NeoProg2013/EDM/blueprint/Пульт/20260916_1610_image (1).png

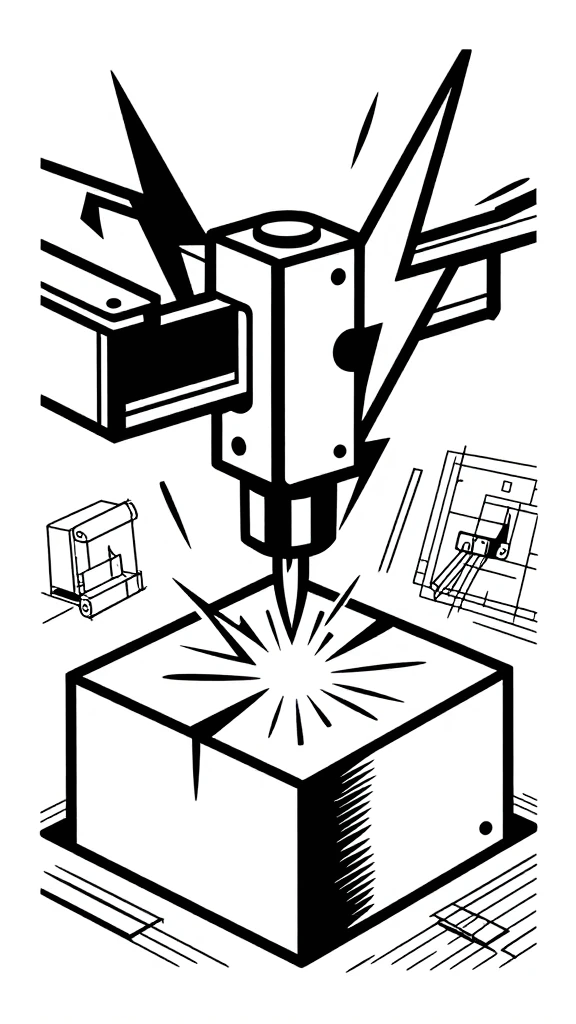
blueprint/Пульт/20260916_1610_image (1).png
