NeoProg2013/EDM/blueprint/Пульт/HighVoltage.webp

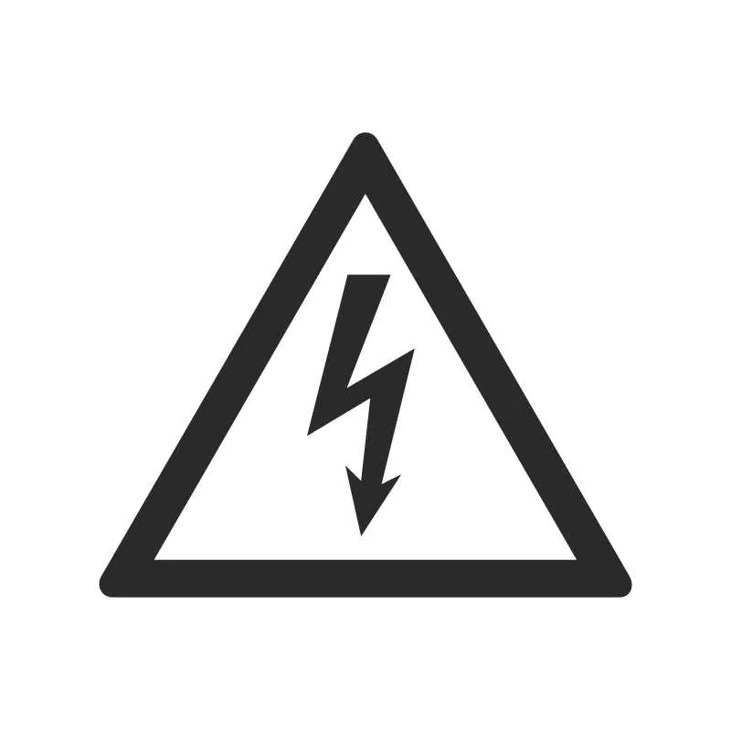
blueprint/Пульт/HighVoltage.webp
