NeoProg2013/EDM/blueprint/Пульт/on-off.png

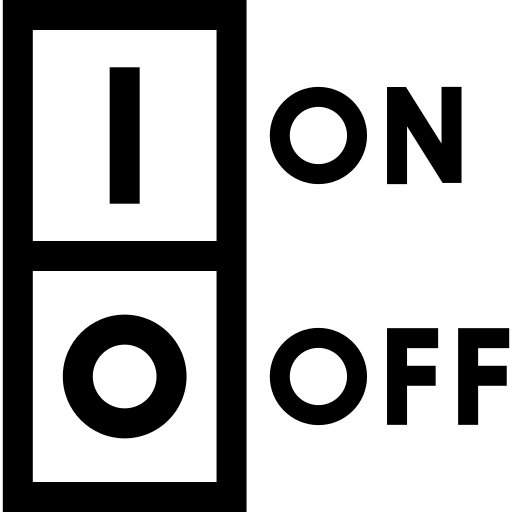
blueprint/Пульт/on-off.png
