NeoProg2013/EDM/blueprint/Снимок экрана 2026-05-17 213727.png

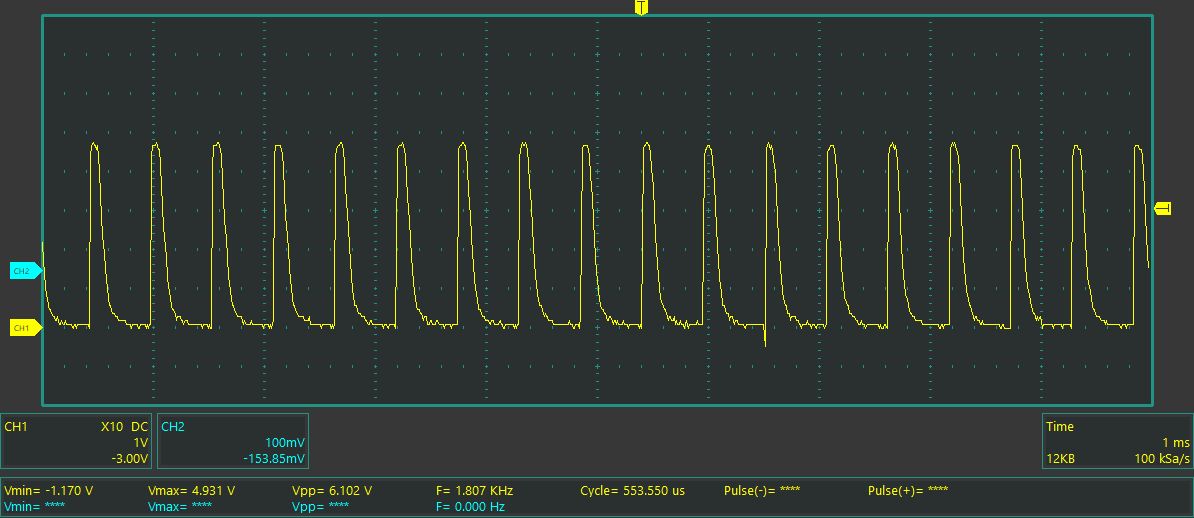
blueprint/Снимок экрана 2026-05-17 213727.png
