NeoProg2013/EDM/firmware/STM32F407VET6.png

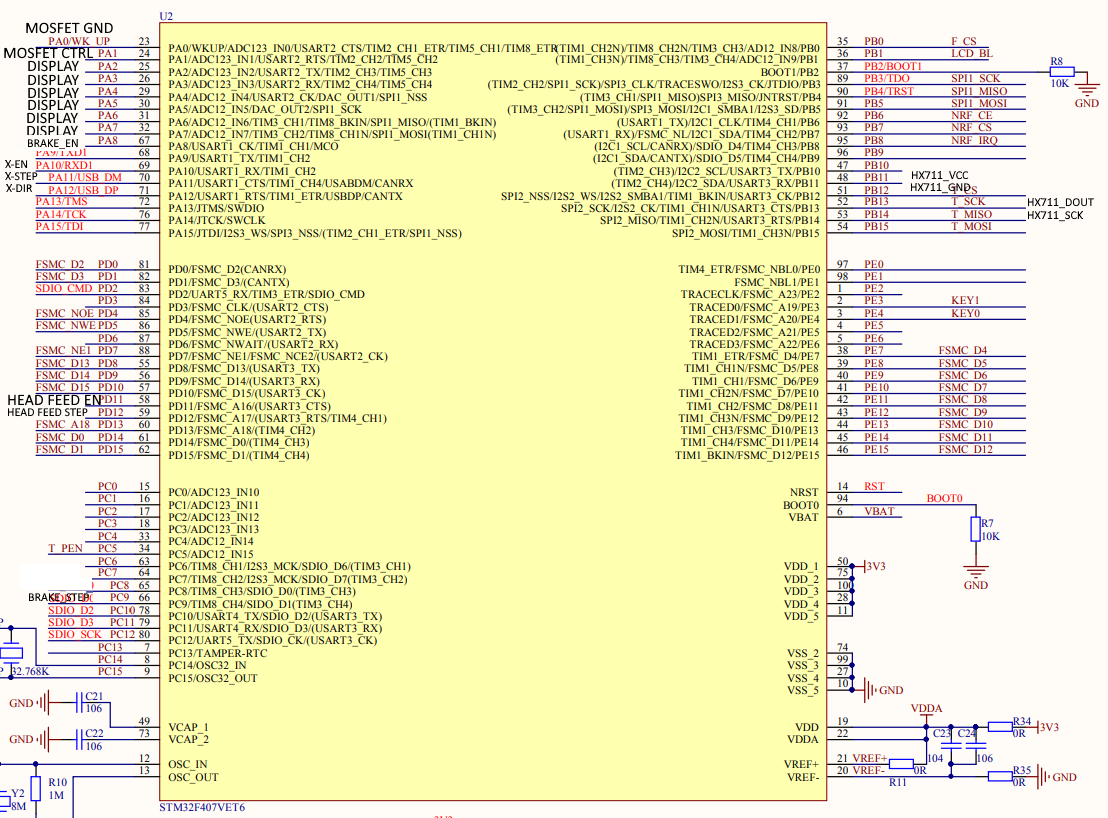
firmware/STM32F407VET6.png
