NeoProg2013/EDM/hardware/laser/bottom.bmp

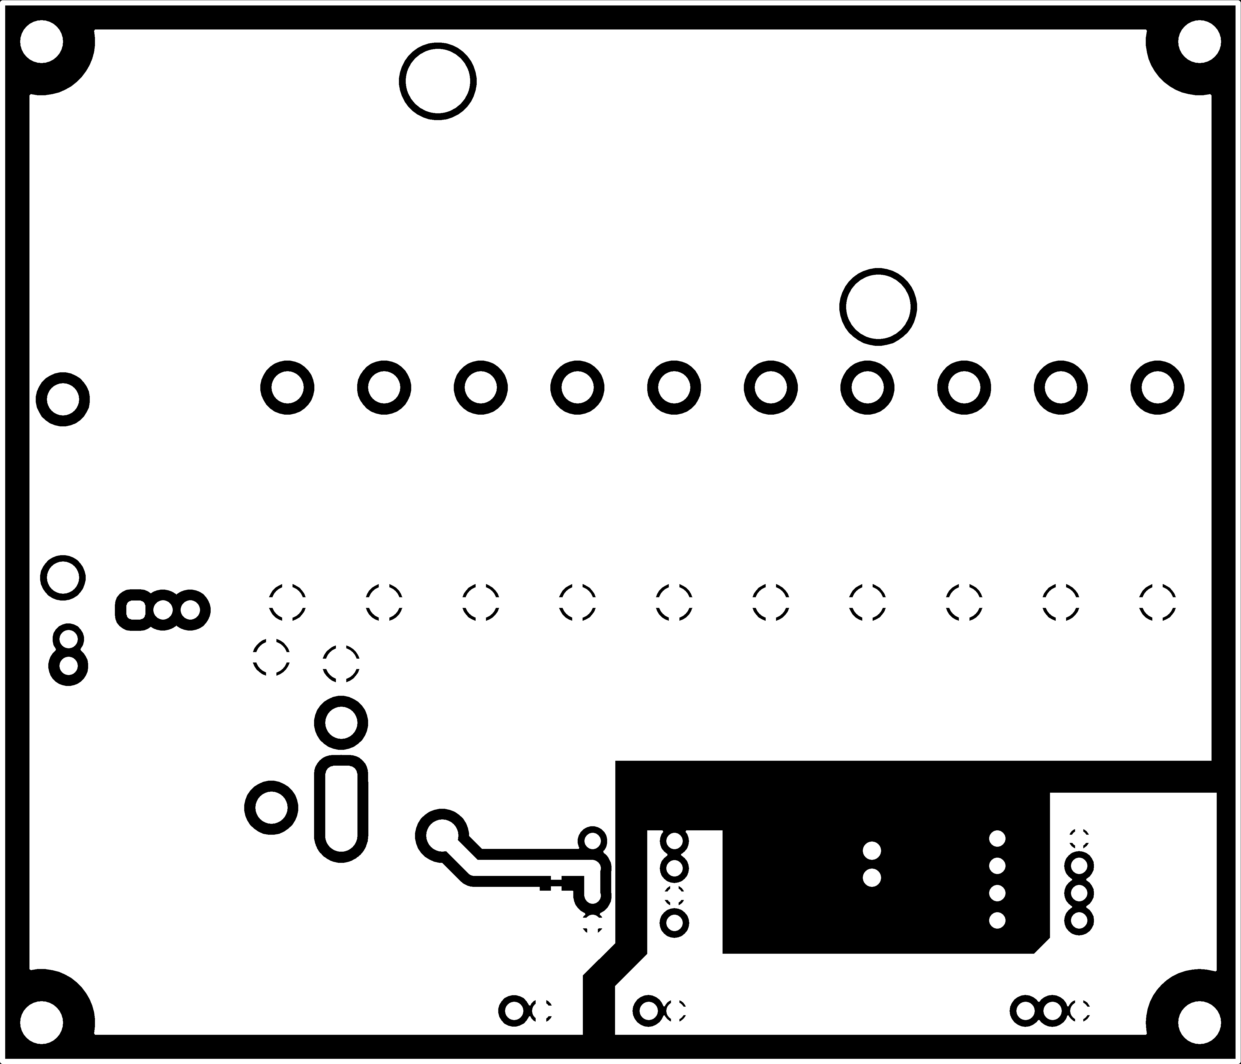
hardware/laser/bottom.bmp
