NeoProg2013/EDM/hardware/laser/top.bmp

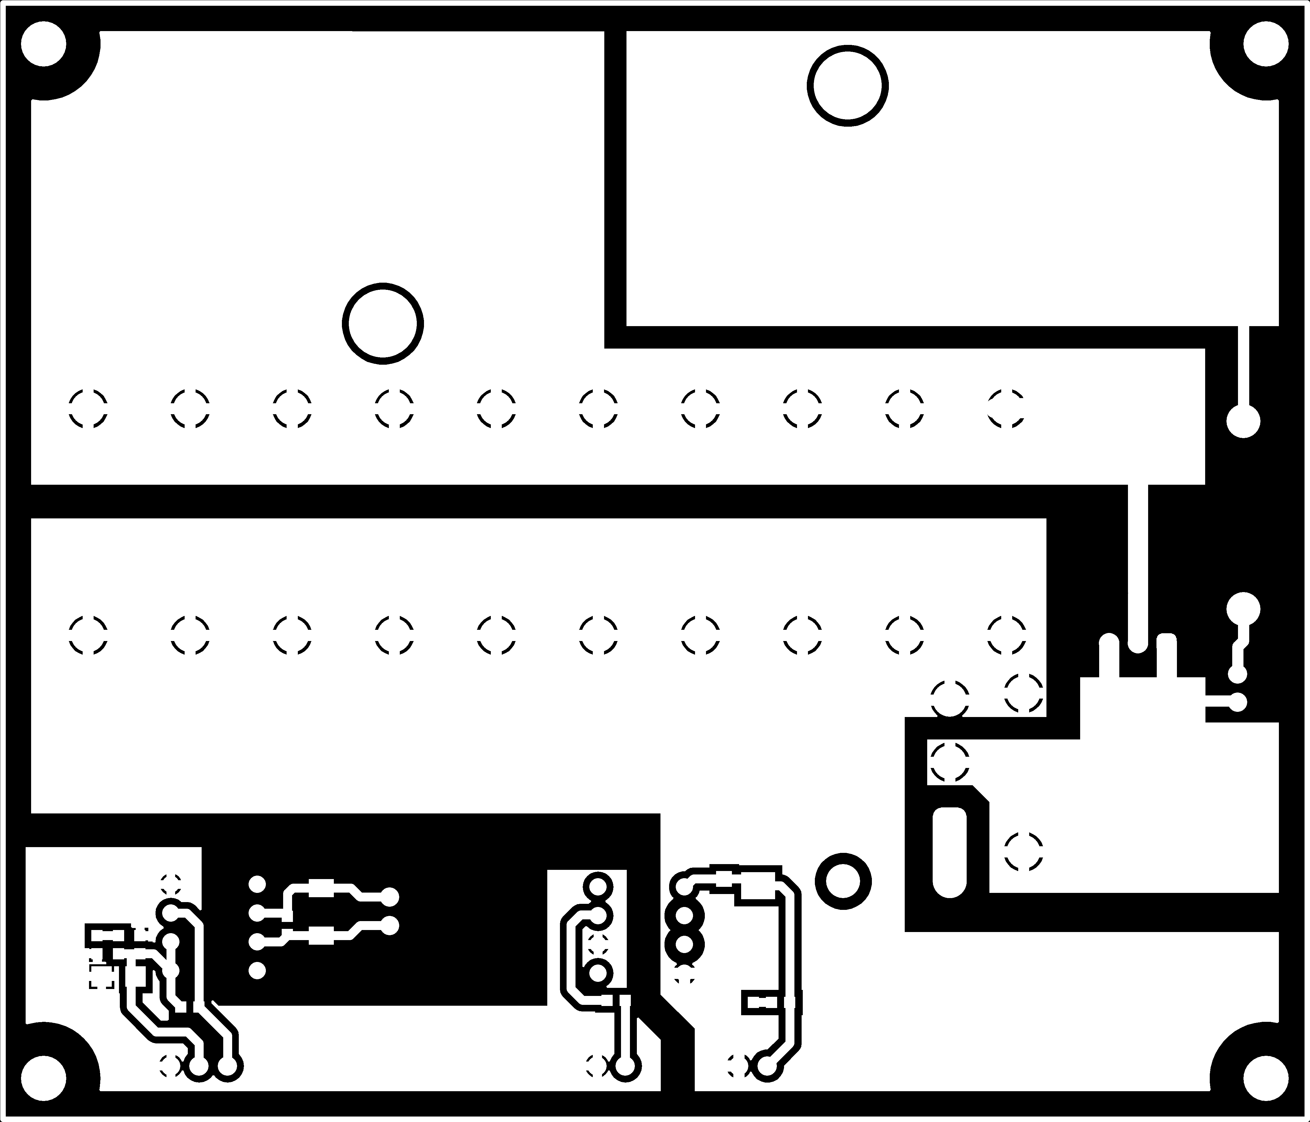
hardware/laser/top.bmp
