NeoProg2013/EDM/img/1.png

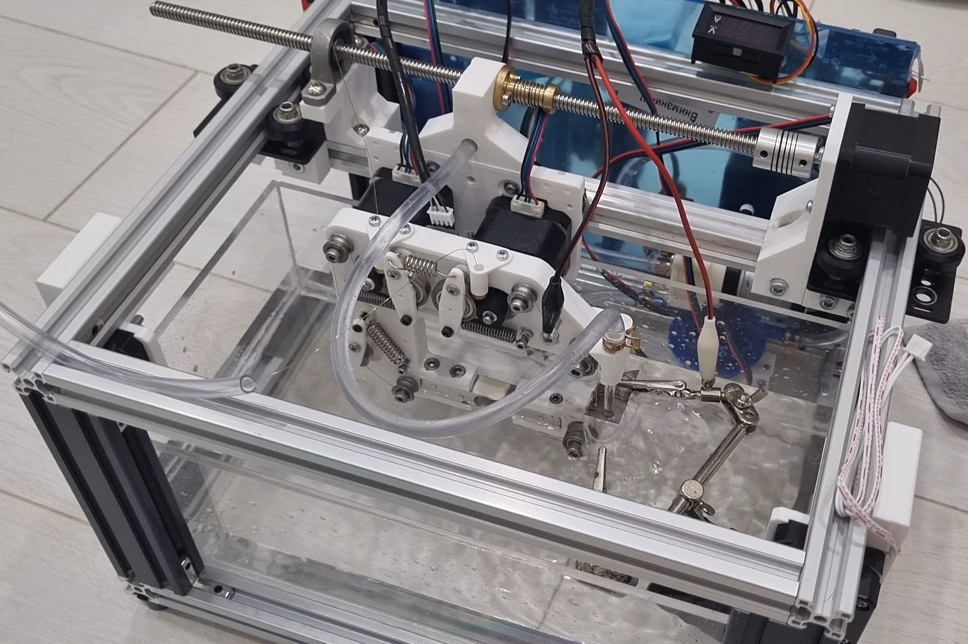
img/1.png
