NeoProg2013/EDM/blueprint/3rd/Mofset module/MosfetBoard v6.step

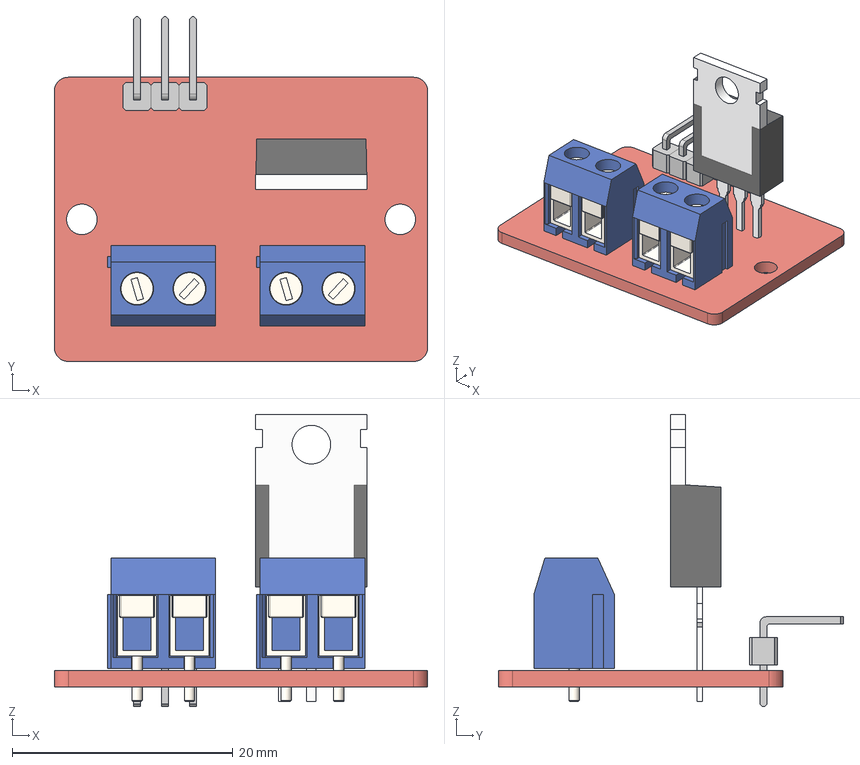
[picture p15: CAD file, 2026-09-25]
blueprint/3rd/Mofset module/MosfetBoard v6.step
33.8 x 31.3 x 26.5 mm
Terminal Screw x 2
FQP30N06L MOSFET With Leads_1
Pin x 3
