NeoProg2013/EDM/blueprint/Аквариум/Кронштейн.stl

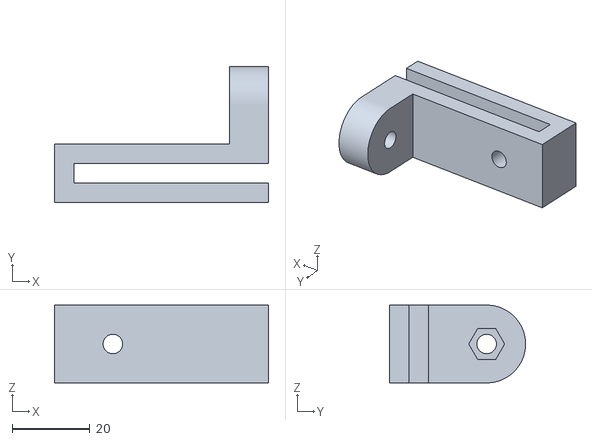
[picture p16: CAD file, 2026-09-25]
blueprint/Аквариум/Кронштейн.stl
55.0 x 35.0 x 20.0
