NeoProg2013/EDM/blueprint/Головка/Кронштейн тефлоновой трубки.stl

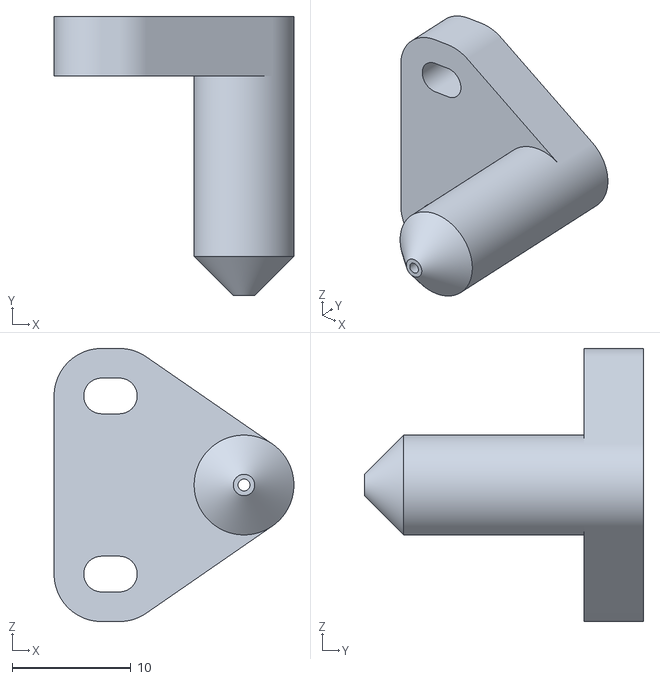
[picture p17: CAD file, 2026-09-25]
blueprint/Головка/Кронштейн тефлоновой трубки.stl
20.2 x 23.5 x 23.0
