NeoProg2013/EDM/blueprint/Пульт/laser.dxf

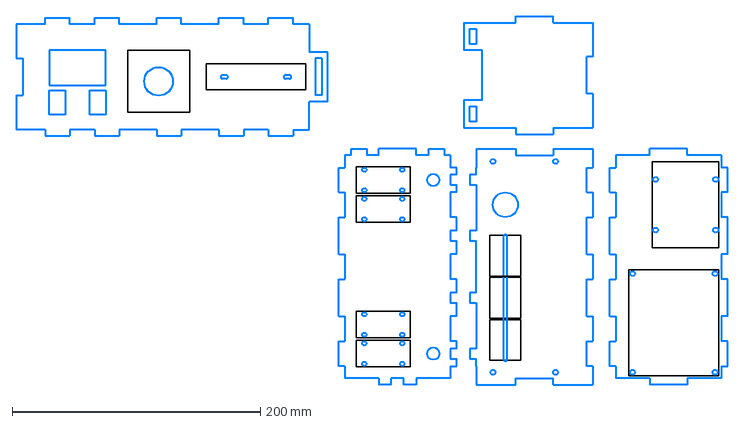
[picture p18: CAD file, 2026-09-25]
blueprint/Пульт/laser.dxf
573.1 x 296.9 mm
