NeoProg2013/EDM/blueprint/Система перекачки жидкости/Кронштайн магнитного фильтра.stl

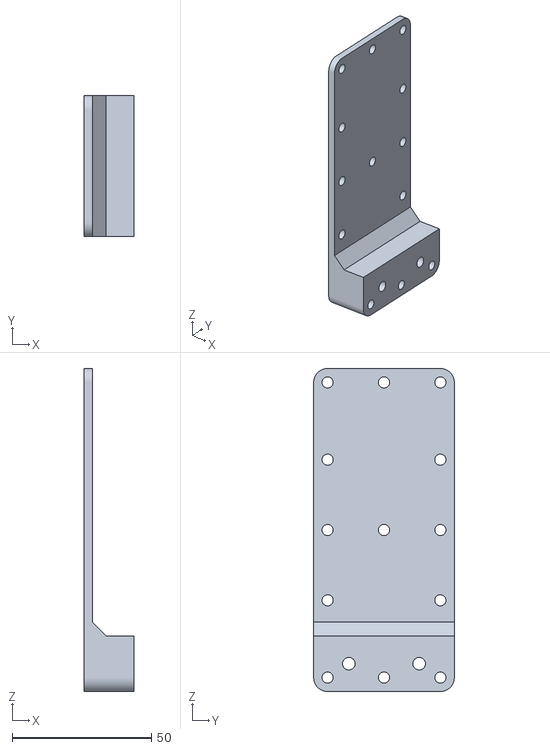
[picture p19: CAD file, 2026-09-25]
blueprint/Система перекачки жидкости/Кронштайн магнитного фильтра.stl
18.0 x 50.5 x 116.0
