NeoProg2013/EDM/blueprint/Система перемотки проволоки/Фиксатор оси.stl

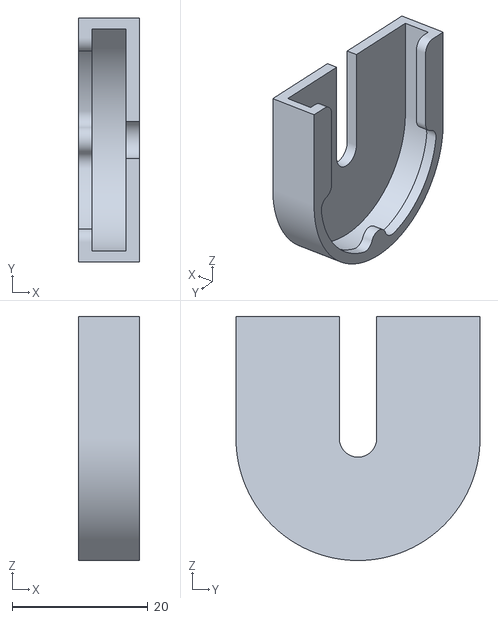
[picture p20: CAD file, 2026-09-25]
blueprint/Система перемотки проволоки/Фиксатор оси.stl
9.00 x 36.0 x 36.0
