NeoProg2013/EDM/blueprint/Аквариум/Кронштейн-2.stl

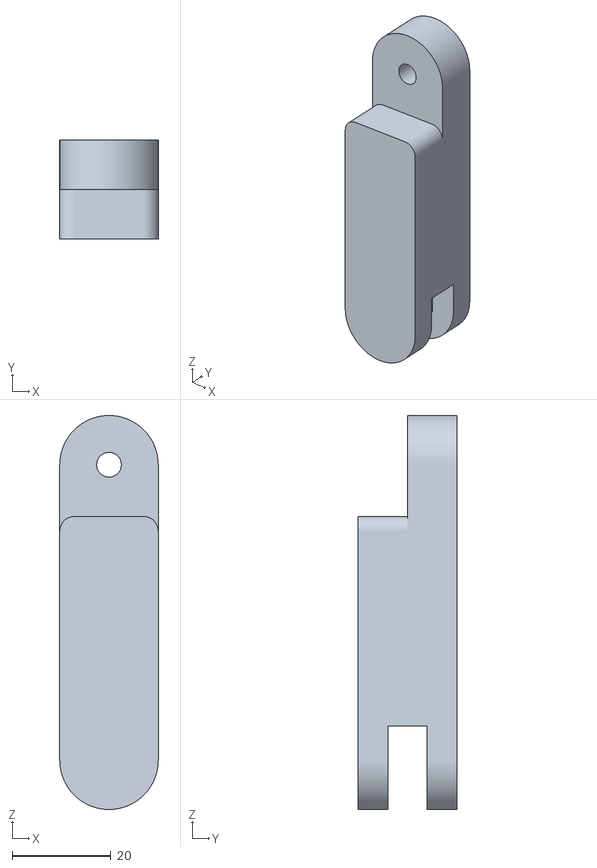
[picture p21: CAD file, 2026-09-25]
blueprint/Аквариум/Кронштейн-2.stl
20.0 x 20.0 x 80.0
