NeoProg2013/EDM/blueprint/Система перекачки жидкости/Магнитный фильтр (крышка).stl

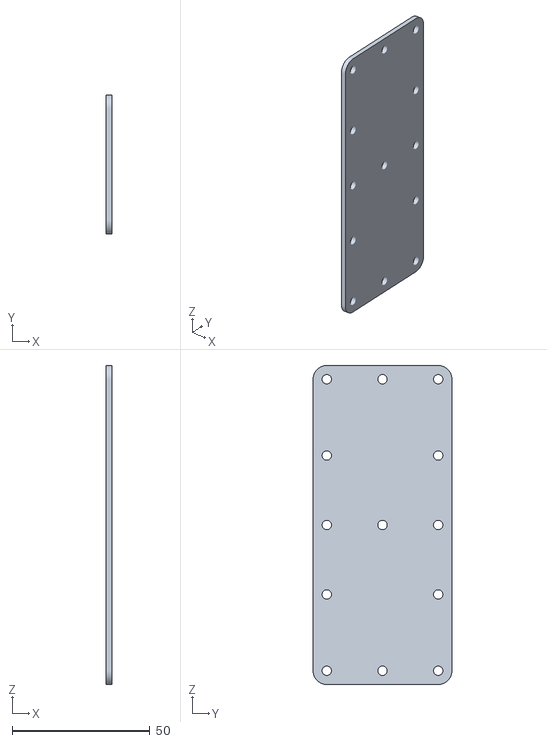
[picture p22: CAD file, 2026-09-25]
blueprint/Система перекачки жидкости/Магнитный фильтр (крышка).stl
2.00 x 50.5 x 116.0
