NeoProg2013/EDM/blueprint/Система перемотки проволоки/Направляющая.stl

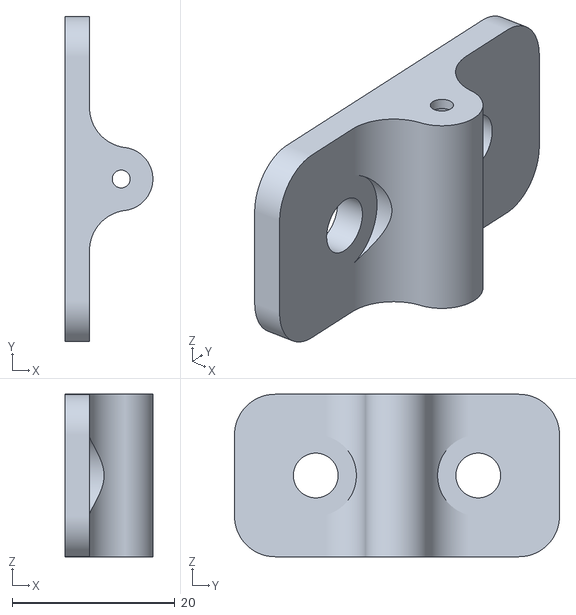
[picture p23: CAD file, 2026-09-25]
blueprint/Система перемотки проволоки/Направляющая.stl
10.8 x 40.0 x 20.0
