NeoProg2013/EDM/blueprint/Система перемотки проволоки/Направляющая тефлоновой трубки.stl

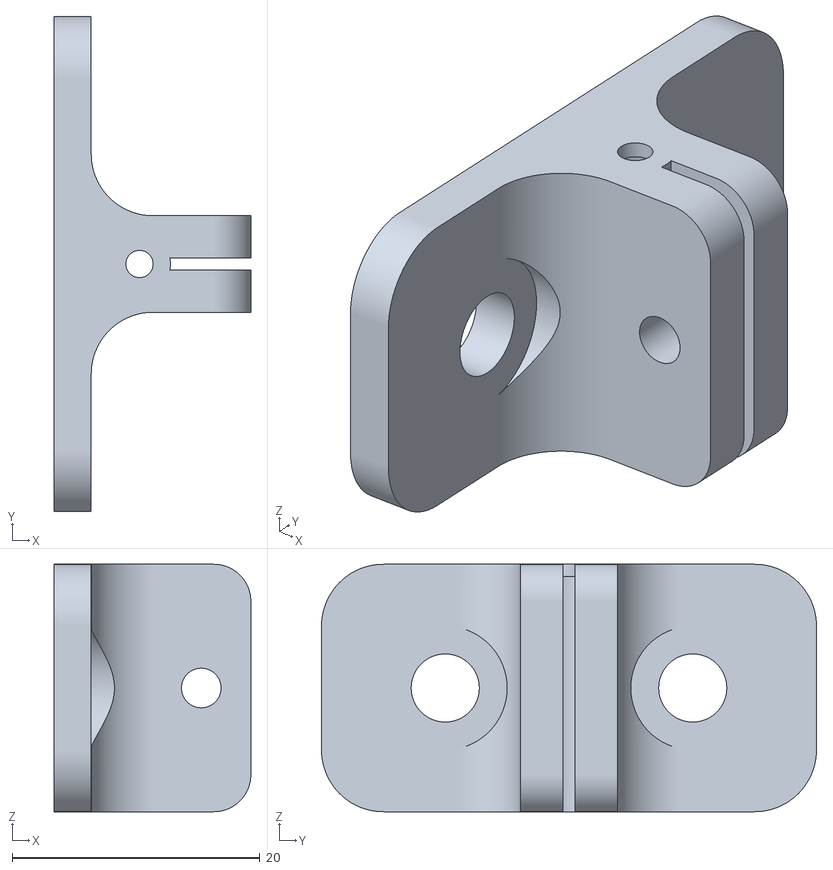
[picture p24: CAD file, 2026-09-25]
blueprint/Система перемотки проволоки/Направляющая тефлоновой трубки.stl
15.9 x 40.0 x 20.0
