NeoProg2013/EDM/(list of files, cad)

Other CAD files:
blueprint/Пульт/Панель.dxf
