NeoProg2013/EDM/(list of files, drawings)

Other design files:
hardware/ControlBoard.PrjPcb
hardware/Main.SchDoc
hardware/PCB.PcbDoc
