NeoProg2013/EDM/firmware/EDM/src/motion/motion_controller.h

#ifndef _MOTION_CONTROLLER_H_
#define _MOTION_CONTROLLER_H_
#include "core.h"
#include "axis.h"


class motion_controller_t {
    struct motion_t {
        enum type_t {
            ABSOLUTE,
            RELATIVE,
        };
        type_t  type    { };
        int32_t x       { };
        int32_t y       { };
    };

    static constexpr uint32_t QUEUE_SIZE = 64;

private:
    stepper_driver_t m_x_driver;
    stepper_driver_t m_y_driver;
    axis_t m_x_axis;
    axis_t m_y_axis;

    motion_t m_current_motion       { };
    motion_t m_queue[QUEUE_SIZE]    { };

    bool     m_is_locked            { };
    bool     m_is_busy              { };
    uint32_t m_queue_head           { };
    uint32_t m_queue_tail           { };
    uint32_t m_queue_size           { };

    // Bresenham
    int32_t m_dx                    { };
    int32_t m_dy                    { };
    int32_t m_err                   { };

public:
    /// ***************************************************************************
    /// @brief  Create motion controller object with internal axis and pin mapping
    /// ***************************************************************************
    motion_controller_t();

    /// ***************************************************************************
    /// @brief  Initialize motion controller and all internal axes/drivers
    /// ***************************************************************************
    void init();

    /// ***************************************************************************
    /// @brief  Process active motion and underlying axis drivers
    /// ***************************************************************************
    void process();

    /// ***************************************************************************
    /// @brief  Queue new linear motion to target point
    /// @param  target_x: target X coordinate in steps
    /// @param  target_y: target Y coordinate in steps
    /// ***************************************************************************
    void move_abs(int32_t target_x, int32_t target_y);

    /// ***************************************************************************
    /// @brief  Queue new linear motion offset
    /// @param  target_x: target X coordinate in steps
    /// @param  target_y: target Y coordinate in steps
    /// ***************************************************************************
    void move_rel(int32_t target_x, int32_t target_y);

    /// ***************************************************************************
    /// @brief Check motion queue size
    /// ***************************************************************************
    bool is_motion_queue_full() const { return m_queue_size == QUEUE_SIZE; }

    /// ***************************************************************************
    /// @brief  Lock / unlock motion progression and prevent issuing new steps
    /// ***************************************************************************
    void lock()   { m_is_locked = true;  }
    void unlock() { m_is_locked = false; }
    bool is_locked() const { return m_is_locked; }

    /// ***************************************************************************
    /// @brief  Check whether controller is executing active motion
    /// @return true if active motion is in progress
    /// ***************************************************************************
    bool is_busy() const { return m_is_busy; }

    int32_t get_current_x() const { return m_x_axis.get_position(); }
    int32_t get_current_y() const { return m_y_axis.get_position(); }

private:
    /// ***************************************************************************
    /// @brief  Add one motion command to ring buffer queue
    /// @param  motion: motion command to enqueue
    /// @return true if queued successfully
    /// ***************************************************************************
    bool enqueue_motion(const motion_t& motion);

    /// ***************************************************************************
    /// @brief  Remove one motion command from ring buffer queue
    /// @param  motion: output pointer for dequeued motion
    /// @return true if one motion was dequeued
    /// ***************************************************************************
    bool dequeue_motion(motion_t* motion);

    /// ***************************************************************************
    /// @brief  Start one queued motion as active motion
    /// @param  motion: queued motion command
    /// ***************************************************************************
    void start_new_motion(const motion_t& motion);
};

#endif // _MOTION_CONTROLLER_H_
