NeoProg2013/EDM/(commit log)

2026-05-08 First issue
    [1.stl, 2.stl, ALUMINIUM PROFILE 400MM.SLDPRT, Aluminium profile 30x30x300.stp, Connectors.SchDoc, ControlBoard.PrjPcb, Draft.SchDoc, Geeetech A20T X-axis Carriage.step]
2026-05-08 Added arduino project
2026-05-10 Первая версия головки
2026-05-11 Вторая версия головки, предфинальная
2026-05-11 Удалены bak файлы
2026-05-12 Первый MVP головки. Напечатан и собран
2026-05-14 Каретка + головка V2
2026-05-16 Small fixed & head V3
    [1.stl, 2.stl, Geeetech A20T X-axis Carriage.step, X-carriage for Artillery Hornet v8.step, config.h, cpu_map.h, defaults.h, Втулка 12-10 мм.stl]
2026-05-17 Головка V5
    [Втулка каретки 6мм.stl, Головка (низ).stl, Каретка 20мм.stl, Кронштейн оси Х.stl, Направляющая проволоки (вход).stl, Хомут 16 мм.stl]
2026-05-17 Головка V6
    [Draft.SchDoc, MCU and memory.SchLib, active.SchLib, analog.SchLib, connectors.PcbLib, connectors.SchLib, controls.PcbLib, controls.SchLib]
2026-05-19 Первый разрез!
    [Втулка тормозного вала.stl, Стабилизатор натяжения.stl]
2026-05-21 Added platformIO project & head V8 done!
    [Втулка тормозного вала.stl]
2026-05-25 Добавлен резистор 1 Ом для контроля тока искры
    [Connectors.SchDoc, ControlBoard.PrjPcb, Draft.SchDoc, Main.SchDoc, MainMCU.SchDoc, Power.SchDoc]
2026-06-08 Добавлен делитель напряжения на выходе датчика тока
    [Main.SchDoc]
2026-06-10 Перенесен чертеж в директорию blueprint
    [ALUMINIUM PROFILE 400MM.SLDPRT, Aluminium profile 30x30x300.stp, Втулка 12-10 мм.stl, Втулка каретки 6мм.stl, Втулка тормозного вала.stl, Головка (низ).stl, Каретка 20мм.stl, Кронштейн оси Х.stl]
2026-06-11 Добавлено сопло для воды
    [Водяное сопло.stl]
2026-06-13 Добавлена рабочая область в сборку PC817 заменен на 6N137 HX711 опрашивается только по готовности
    [Main.SchDoc, Водяное сопло.stl]
2026-06-19 Обновлена каретка головка Добавлена рабочая область (аквариум)
2026-06-19 Удалено ожидание готовности для HX711 из функции чтения для минимизации задержки опроса датчика
2026-06-24 Добавлена ось Х
2026-06-25 Обновлена сборка
2026-07-10 Porting firmware to STM32F407VE (#1)
    [Configuration.h, Configuration_adv.h, Main.SchDoc, esp32.csv]
2026-07-11 Добавлена система перемотки проволоки
2026-07-11 Исправлена опечатка в имени файла
2026-07-15 Первая версия системы перемотки проволоки
2026-07-17 Система перемотки проволоки готова
2026-07-18 Распихал все по директориям
2026-07-18 MVP магнитного фильтра
2026-07-20 Первая версия PCB
    [ControlBoard.PrjPcb, Main.SchDoc, PCB.PcbDoc]
2026-07-24 hardware PCB changes
    [Main.SchDoc, PCB.PcbDoc]
2026-08-02 First version of spark PCB
    [Main.SchDoc, PCB.PcbDoc]
2026-08-16 First issue of PCB (spark generator) (#2)
    [ControlBoard.PrjPcb, Main.SchDoc, PCB.PcbDoc]
2026-08-18 Added 1N4756APF
    [Main.SchDoc, PCB.PcbDoc]
2026-09-21 - Добавлен STM32F103 для интерфейса управления - Подготовка к реализации motion controller - Иготовлен корпус для электроники draft
    [Панель.dxf]
2026-09-27 Изменен главный экран
2026-11-08 Добавлен персер gcode. Базовый
